nateGeorge/ESP-8266-particle-sensor/NodeMcu/proto board before soldering.jpg

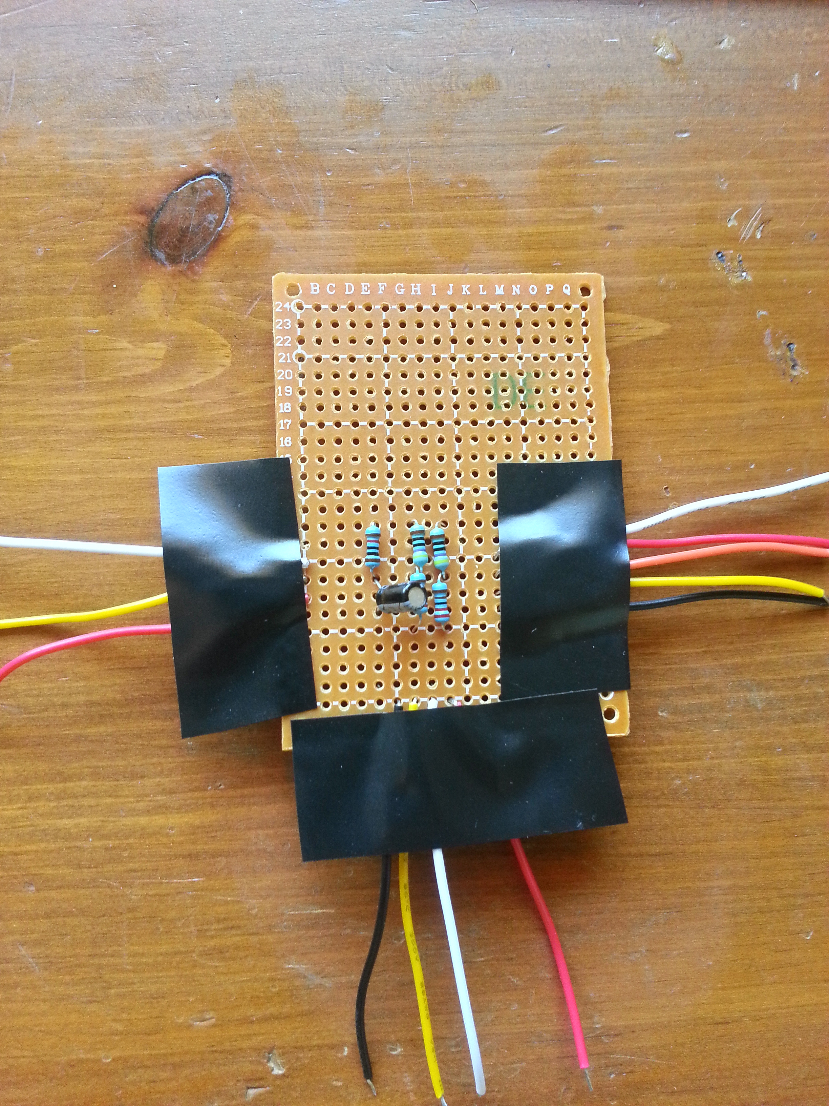
NodeMcu/proto board before soldering.jpg
