nateGeorge/ESP-8266-particle-sensor/NodeMcu/proto board with connections.jpg

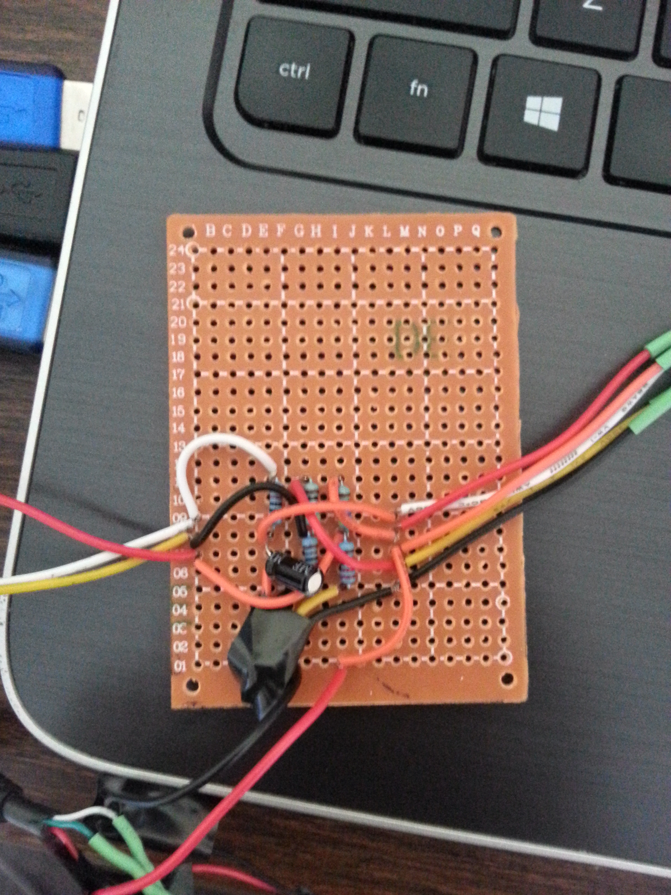
NodeMcu/proto board with connections.jpg
