nateGeorge/ESP-8266-particle-sensor/NodeMcu/enclosure/box-20151013_195903_868115.pdf

Cut Width: 0.0000mm
Material Thickness: 2.7000mm
W x D x H: 101.60mm x 88.90mm x 63.50mm Produced by BoxMaker v2.0.1 on 10/13/2015 at 19:59:03 http://boxmaker.connectionlab.org
