nateGeorge/ESP-8266-particle-sensor/arduino+esp01/correlation data/8-6-15 correlations.png

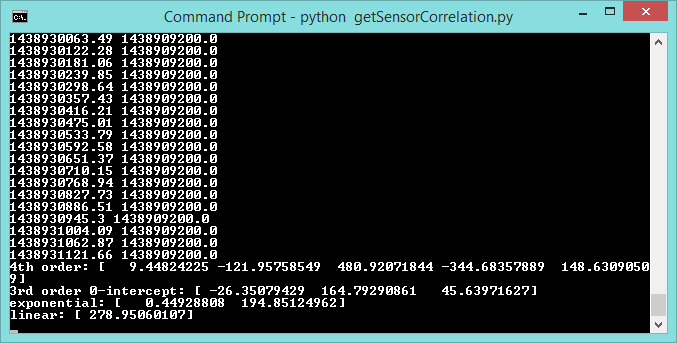
arduino+esp01/correlation data/8-6-15 correlations.png
