nateGeorge/ESP-8266-particle-sensor/arduino+esp01/correlation data/data from linear fit.png

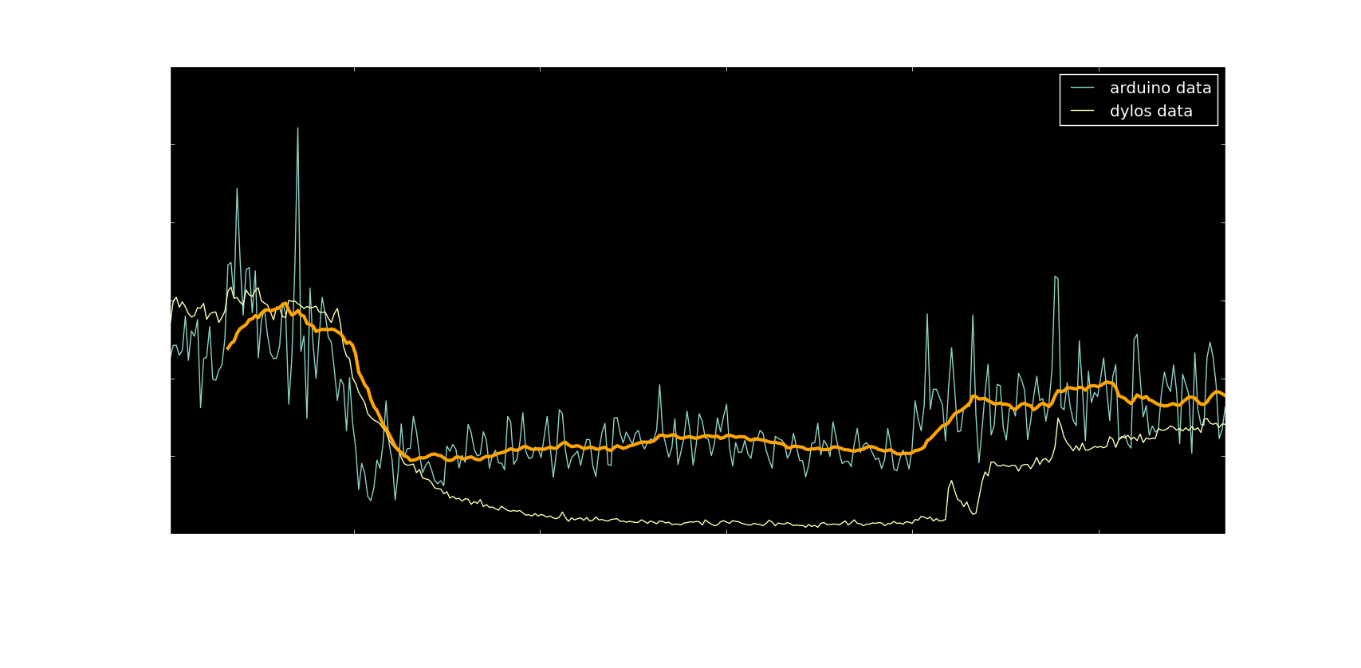
arduino+esp01/correlation data/data from linear fit.png
