nateGeorge/ESP-8266-particle-sensor/arduino+esp01/correlation data/low P1 ratio.png

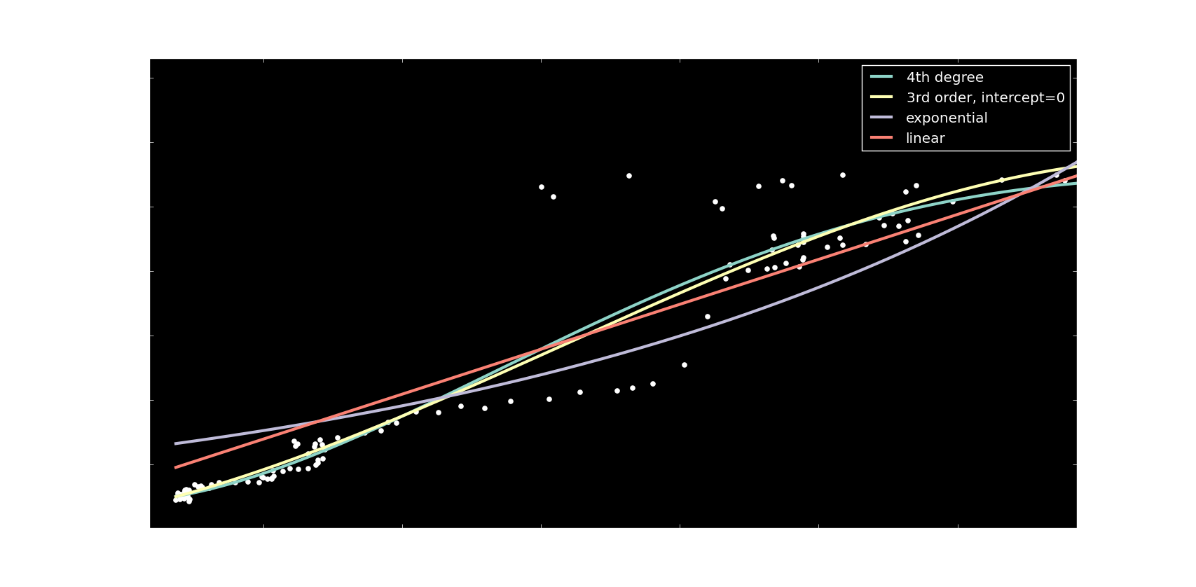
arduino+esp01/correlation data/low P1 ratio.png
