nateGeorge/ESP-8266-particle-sensor/arduino+esp01/correlation data/P1 ratio dylos fit.png

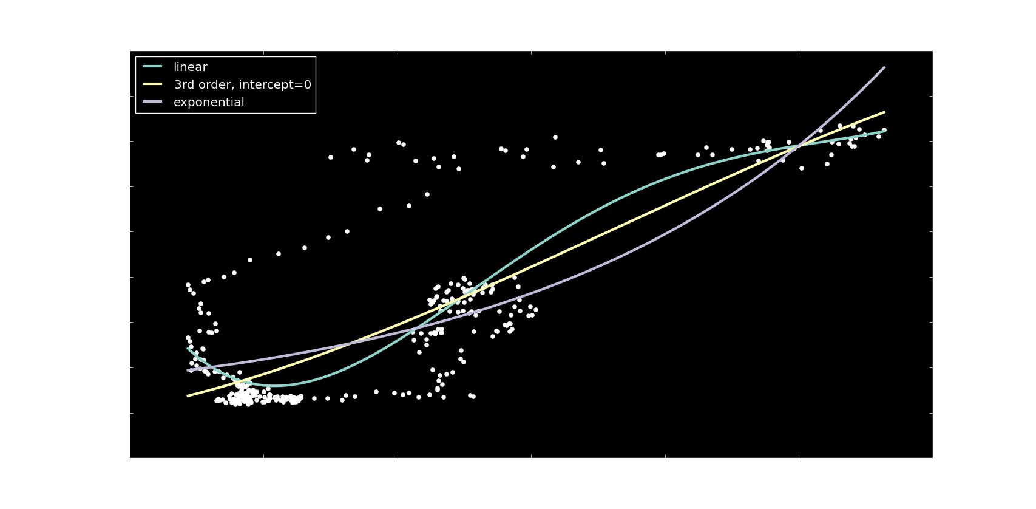
arduino+esp01/correlation data/P1 ratio dylos fit.png
