nateGeorge/ESP-8266-particle-sensor/arduino+esp01/correlation data/raw p1 data.png

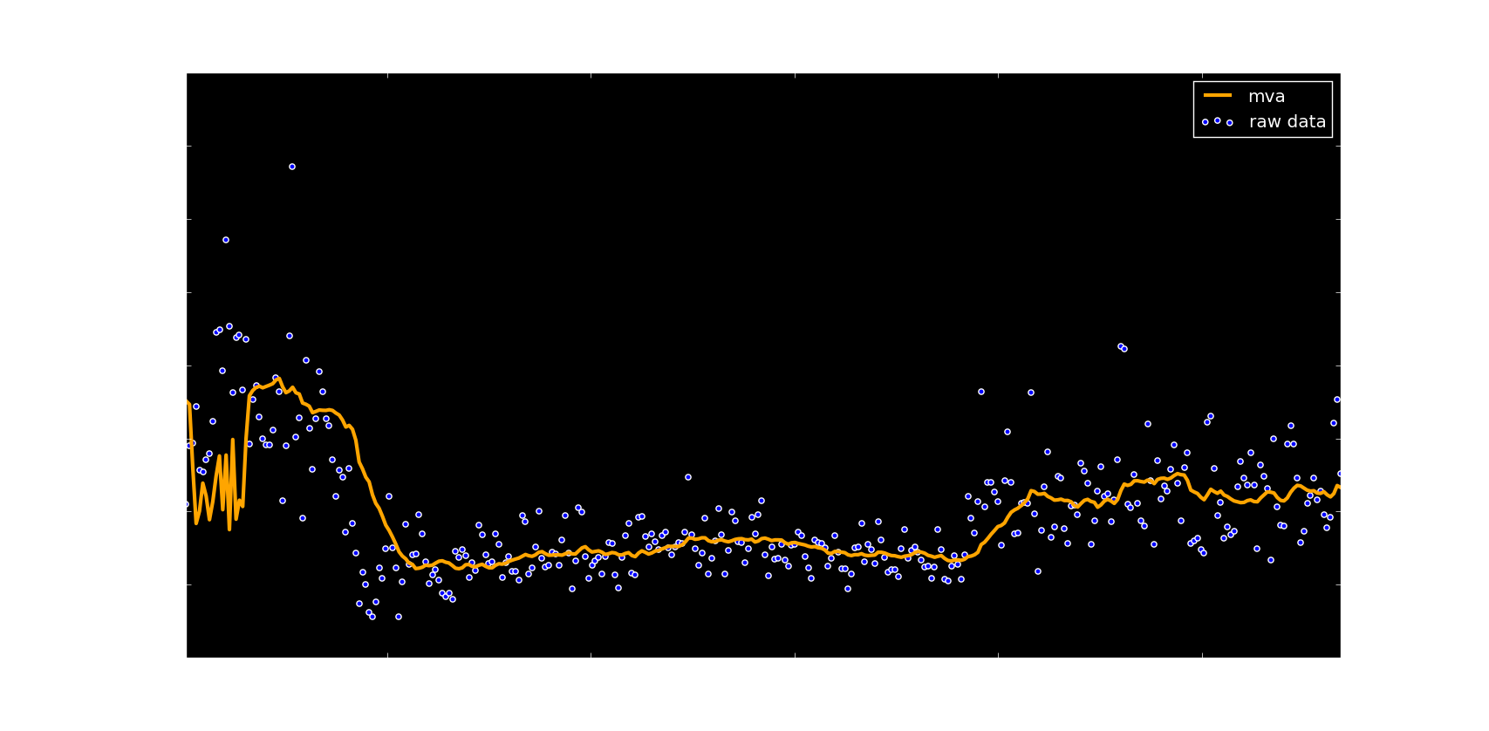
arduino+esp01/correlation data/raw p1 data.png
