nateGeorge/ESP-8266-particle-sensor/background info/dylos plot.png

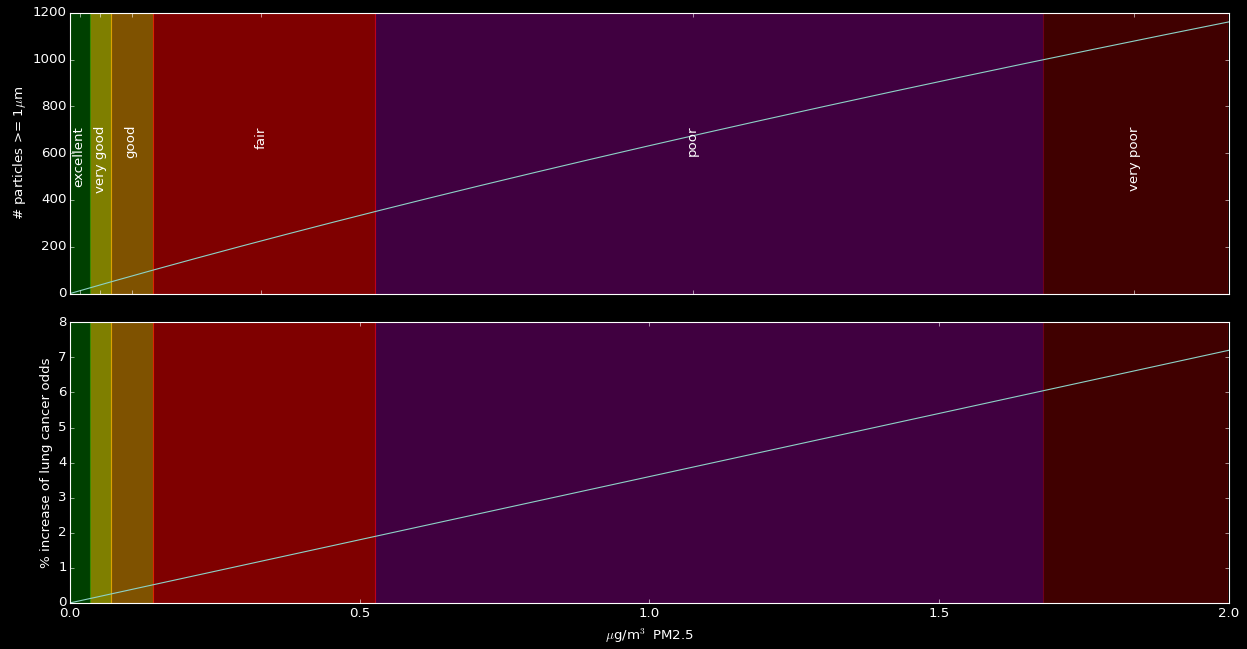
background info/dylos plot.png
