nateGeorge/ESP-8266-particle-sensor/background info/overall plot.png

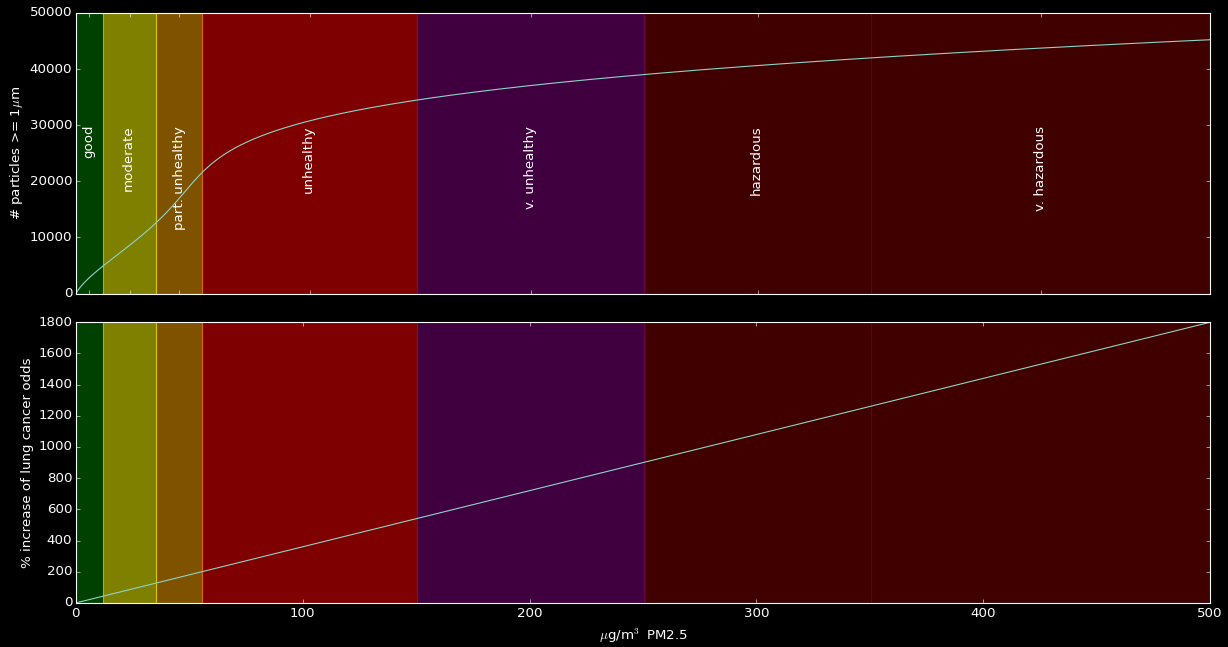
background info/overall plot.png
