nateGeorge/ESP-8266-particle-sensor/NodeMcu/5V downconversion.bmp

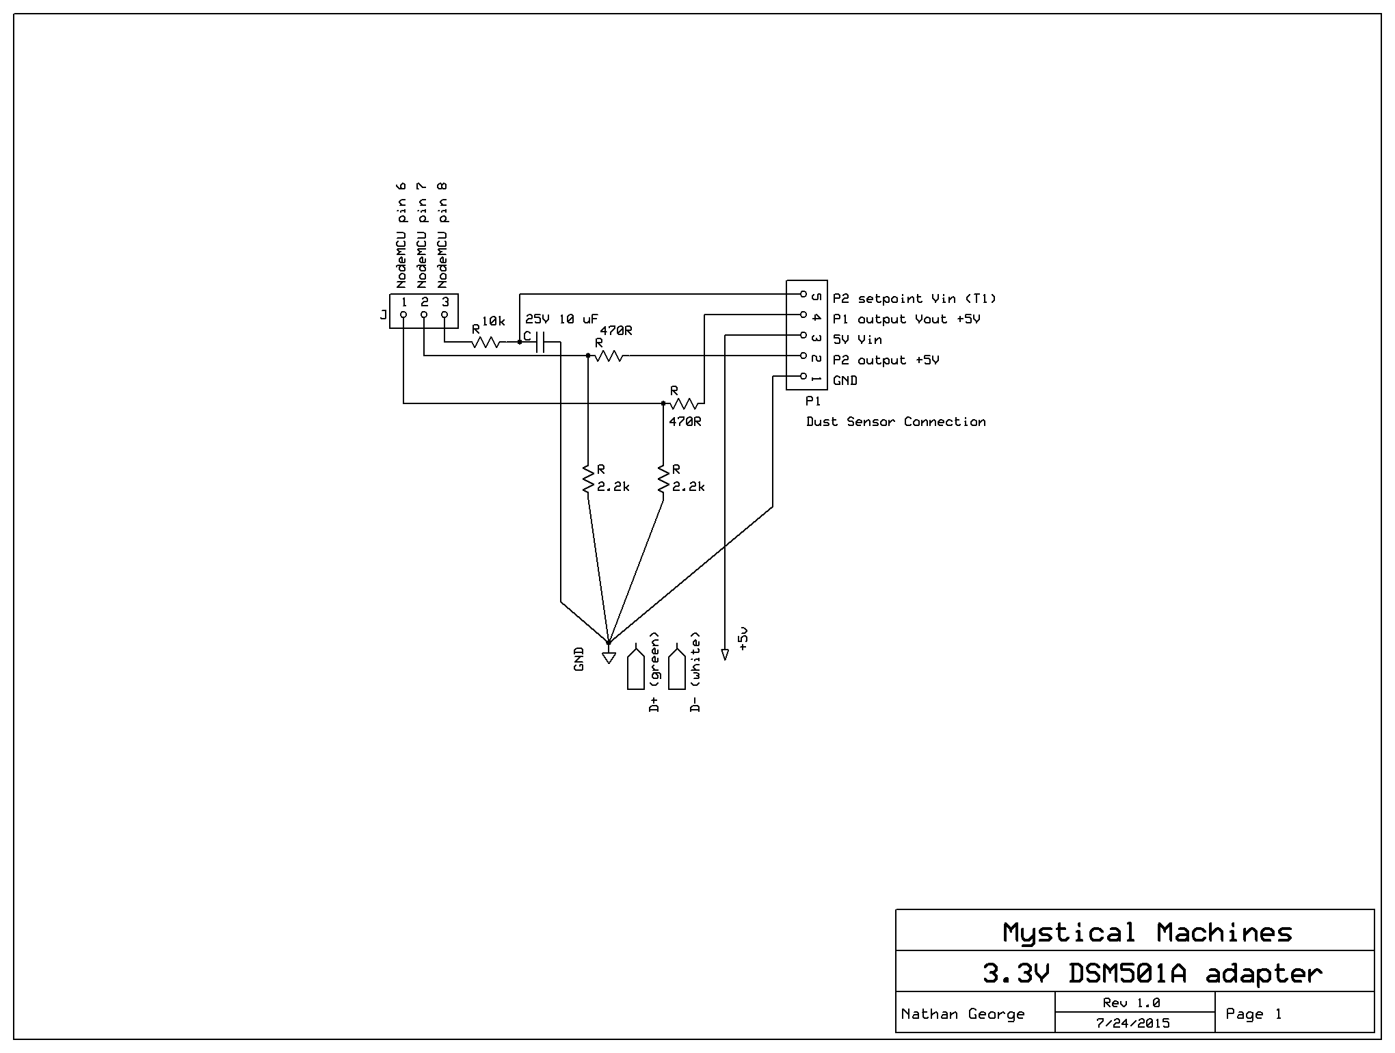
NodeMcu/5V downconversion.bmp
