nateGeorge/ESP-8266-particle-sensor/spec sheets/DSM501A ratio to mg-m3.png

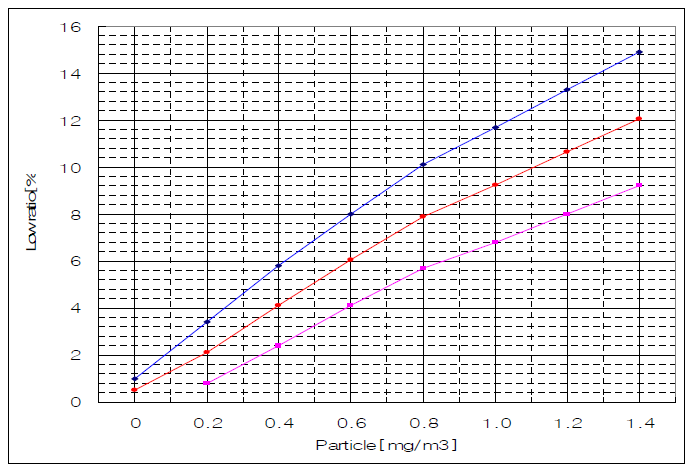
spec sheets/DSM501A ratio to mg-m3.png
