nateGeorge/ESP-8266-particle-sensor/spec sheets/DSM501A ratio to particle-001 ft3.png

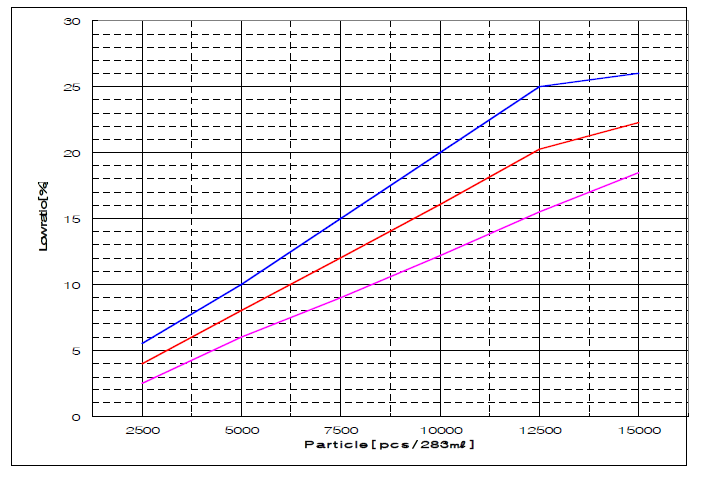
spec sheets/DSM501A ratio to particle-001 ft3.png
