nateGeorge/ESP-8266-particle-sensor/business documents/costs.xlsx

item | cost
nodeMCU devkit | 5
custom circuit | 1
lcd screen | 2
ppd42ns | 10
case | 10
other (cables, etc) | 1
total | 29
 | 75.4
