nateGeorge/ESP-8266-particle-sensor/NodeMcu/cost and power calculations.xlsx

Sheet: costs
 | total cost | cost per item | # items | item | link
 | 12 | 12 | 1 | PPD42NS | http://www.aliexpress.com/item/Free-shipping-PM2-5-dust-sensor-PPD42NJ-PPD42NS-with-cable/32408582269.html
 | 2.24 | 2.24 | 1 | ESP8266 ESP-12 | http://www.aliexpress.com/item/Free-Shipping-ESP8266-serial-WIFI-model-ESP-12-ESP-12E-ESP12E-Authenticity-Guaranteed-ESP12/32353579773.html
 | 0.34 | 0.34 | 1 | battery charger | http://www.alibaba.com/product-detail/TP4056-1A-Lipo-Battery-Charging-Board_60305109787.html
 | 0 | 2.45 |  | 4500 mAh batteries | http://www.alibaba.com/product-detail/9-6Wh-high-capacity-4500mah-Li_60279237019.html
 | 3.14 | 1.57 | 2 | 8800 mAh batteries | http://www.aliexpress.com/item/Free-Shipping-10-Pcs-18650-battery-Ultrafire-bateria-3-7V-8800mAh-Li-ion-Rechargeable-Battery-Flashlight/32297733829.html
 | 0.8 | 0.8 | 1 | battery holder | http://www.aliexpress.com/item/2Pcs-lot-18650-Battery-Holder-Battery-Storage-Box-With-Pin-TBH-186502AP-Free-Shipping/32336098533.html
 | 0.085 | 0.085 | 1 | 5v regulator | http://www.aliexpress.com/item/10pcs-L7805CV-L7805-7805-Voltage-Regulator-5V-1-5A-TO-220/32266509032.html
 | 0.04 | 0.04 | 1 | 3.3v regulator | http://www.aliexpress.com/item/10pcs-AMS1117-3-3-AMS1117-LM1117-1117-3-3V-1A-Voltage-Regulator/32409097011.html
 | 0.08 | 0.08 | 1 | micro usb connector | http://www.aliexpress.com/item/Short-term-Sacrifices-5pcs-USB-Micro-Type-B-5pin-Female-Jack-Connector-SMT-Surface-Mount/32349977492.html
 | 0.72 | 0.72 | 1 | micro usb cable | http://www.aliexpress.com/item/1-Meter-3-Feet-Ruggedized-Fabric-Braided-USB-Male-to-Micro-USB-Male-Data-Sync-Charging/32340270515.html
 | 3.6 | 3.6 | 1 | tft screen | http://www.aliexpress.com/item/Free-shipping-New-1-44-inch-LCD-color-screen-for-arduino-1-44-TFT-SPI-serial/32233128819.html
 | 0.75 | 0.75 | 1 | rgb led | http://www.aliexpress.com/item/1Pcs-3-Colour-RGB-SMD-LED-Board-Module-5050-Full-Color-LED-3-3-5V-for/2055617889.html
 | 5 | 5 | 1 | circuit board
 | 5 | 5 | 1 | case
subtotal | 33.795
 |  | 0.001798 |  | smd resistors 10k | http://www.aliexpress.com/item/0603-10K-Ohm-5-1-10W-RoHS-Chip-Fixed-Resistor-SMD-Resistor-5000pcs-full-reel/32260947174.html
 | WIRELESS OPTION
 | 2.4 | 2.4 | 1 | wireless charging reciever | http://www.aliexpress.com/item/Ultra-Thin-S4-i9500-Qi-Wireless-Charger-Charging-Receiver-Adapter-Coil-for-Samsung-Galaxy-S4-i9500/32344269583.html
 | 4.13 | 4.13 | 1 | wireless charging pad | http://www.aliexpress.com/item/5-Colors-Universal-Qi-Wireless-Power-Charging-Charger-Pad-For-Mobile-Phone-for-iPhone-6-High/32357207384.html
subtotal | 6.53

Sheet: power usage
piece | time fraction | A | V | power (W) | power (Wh) required run for 3 hours
ESP8266 wifi | 0.1666666667 | 0.4 | 3.7 | 1.48 | 6.36 | Wh
dust sensor | 1 | 0.1 | 6.4 | 0.64 | 1718.918919 | mAh
 |  |  |  |  | hours with 9.6Wh (4800 mAh)
 |  |  |  |  | 4.528301887
sum |  |  |  | 2.12
