nateGeorge/ESP-8266-particle-sensor/background info/DSM501A ratio to mg-m3.xlsx

Sheet: pcs per 0.01ft3
LPO | particles / 0.01ft3 | LPO | upper error | LPO | lower error
3.993520653 | 2526.053319 | 5.496683866 | 2506.01775 | 2.424884318 | 2524.354189
7.993384723 | 5000.056638 | 9.954180142 | 5002.180549 | 5.901869609 | 4997.791132
14.0916737 | 8797.823415 | 17.621332 | 8844.974258 | 9.117981887 | 7579.26439
20.25486942 | 12509.00539 | 25.02613828 | 12514.17357 | 12.39945401 | 10160.80845
22.29405135 | 15002.54869 | 26.01967592 | 15028.24803 | 18.50306693 | 14976.77856

Sheet: DSM501A ratio to mg-m3
low pulse ratio | mg/m3 | LPO | upper error limit | LPO | lower error limit
0.5474452555 | -0.0001300345025 | 1.02189781 | -0.0002427310713 | 0.802919708 | 0.2017095203
2.116788321 | 0.1966468436 | 3.430656934 | 0.2010853546 | 2.445255474 | 0.3984690605
4.160583942 | 0.398061619 | 5.839416058 | 0.3976628465 | 4.124087591 | 0.5952199317
6.094890511 | 0.5971271044 | 8.02919708 | 0.5966676491 | 5.693430657 | 0.7967474036
7.919708029 | 0.7962185967 | 10.1459854 | 0.7956897897 | 6.824817518 | 0.9960036063
9.233576642 | 0.9954314545 | 11.67883212 | 0.9972259306 | 8.02919708 | 1.195242471
10.65693431 | 1.194618305 | 13.32116788 | 1.193985471 | 9.233576642 | 1.396856633
12.04379562 | 1.393813825 | 14.89051095 | 1.395512943

Sheet: Resistors for v1 output
R | size (um)
inf | 2.5
100k | 1.75
27k | 1

Sheet: convert part-ft3 to ug-m3
y = 4E-16x4 – 2E-11x3 + 3E-07x2 + 0.0014x + 1.9915
from aircasting thesis https://dl.dropboxusercontent.com/u/29720355/Besser%20Thesis%20FINAL.pdf
using shinyei ppd60v t2
Subsequent particle studies have shown distributions for airborne particles proportional to 1/(diameter)^2.1.
(number of particles > 1 µm)* [1/(ratio of particle diameters)^2.1 ]
http://www.pmeasuring.com/wrap/filesApp/BasicGuide/file_1/ver_1317144880/basicguide.pdf
conversion factor
4.28709385
particle size 1 | size 2
0.5 | 1

Sheet: limits for exposure
aircasting 2.5um | hunderds of particles per cubic foot, lower | upper | lower ug/m3 | upper |  | y = 4E-16x4 – 2E-11x3 + 3E-07x2 + 0.0014x + 1.9915
very poor | 7500 |  | 22.194625
poor | 5000 | 7500 | 14.2415 | 22.194625
fair | 2500 | 5000 | 7.069625 | 14.2415
good | 2500 |  | 7.069625
 |  |  |  |  | converts hundreds of particles per ft3 to ug/m3, which is the same as particles per 0.01 ft3 output by shinyei
1 um counts per 0.01 ft3 converted to EPA scale | 41976.60367 |  | 350.0000072 |  | 4E-16x4 – 2E-11x3 + 3E-07x2 + 0.0014x + 1.9915
 | 39003.64076 |  | 250.0000024
from aircasting thesis https://dl.dropboxusercontent.com/u/29720355/Besser%20Thesis%20FINAL.pdf | 34452.2175 |  | 149.9999998
 | 21304.58182 |  | 54.99999839
 | 12470.54384 |  | 35.00000111
 | 4919.226481 |  | 11.9999999
dylos 1um |  |  |  |  | converted to 0.5 um with 4.29
very poor | 1000 |  | 1.68 |  | 4290
poor | 350 | 1000 | 0.53 | 1.68 | 1501.5
fair | 100 | 350 | 0.14 | 0.53 | 429
good | 50 | 100 | 0.07 | 0.14 | 214.5
very good | 25 | 50 | 0.04 | 0.07 | 107.25
excellent | 0 | 25 | 0.00 | 0.04 | 0
dylos 0.5um |  |  |  |  | converted to 1 um with 4.29 factor
very poor | 3000 |  | 30 |  | 699.3006993
poor | 1050 | 3000 | 10.5 | 30 | 244.7552448
fair | 300 | 1050 | 3 | 10.5 | 69.93006993
good | 150 | 300 | 1.5 | 3 | 34.96503497
very good | 75 | 150 | 0.75 | 1.5 | 17.48251748
excellent | 0 | 75 | 0 | 0.75 | 0
US EPA NAAQS | http://www.epa.gov/air/criteria.html | http://www.epa.gov/airquality/particlepollution/2012/decfsstandards.pdf
24 hour period |  |  | 35
1 year |  |  | 12
very hazardous |  |  | 350
hazardous |  |  | 250 | 350
very unhealthy |  |  | 150 | 250
unhealthy |  |  | 55 | 150
unhealthy for sensitive groups |  |  | 35 | 55
moderate |  |  | 12 | 35
good |  |  | 0 | 12
WHO 2.5um standards | http://www.who.int/mediacentre/factsheets/fs313/en/
24 hour |  |  | 25
1 year |  |  | 10

Sheet: Low P1 ratio to counts
P1 ratio | particles in 0.01 cu ft
0.6998420221 | 98.30508475
2.678515008 | 789.8305085
3.302527646 | 966.1016949
3.859399684 | 1101.694915
1.197472354 | 261.0169492
1.596366509 | 383.0508475
