nateGeorge/ESP-8266-particle-sensor/(commit log)

2015-07-26 added pics of proto board
2015-07-28 had tx, rx reversed on esp
    [particle_monitor_with_P2_output_sparkfun_logging.ino]
2015-08-01 lowered timeout and fixed re
    [save arduino data.py]
2015-08-01 had p2/p1 concs switched
2015-08-01 added NAAQS and WHO standards, conversion to ug/m3
    [DSM501A ratio to mg-m3.xlsx]
2015-08-02 added more data on thresholds
    [DSM501A ratio to mg-m3.xlsx]
2015-08-02 fixed date in filename
    [save arduino data.py, save dylos data.py]
2015-08-02 changed fan pin #
    [2015-08-02 09-17-57 dylos data.csv, 2015-08-02 09-18-19 arduino data.csv]
2015-08-02 added data
    [2015-08-02 09-17-57 dylos data.csv, 2015-08-02 09-18-19 arduino data.csv]
2015-08-02 Revert "initial commit"
    This reverts commit 0eaaa4d6554e546bd2d77d9edb31613e7b3fff55.
    [getSensorCorrelation with lots of filtering.py, getSensorCorrelation.py]
2015-08-02 Revert "Revert "initial commit""
    This reverts commit f83eabcf0bed7aa63dcd10e2291b99bf970a7a38.
    [getSensorCorrelation with lots of filtering.py]
2015-08-07 initial commi
    [2015-08-06 21-14-21 arduino data.csv, 2015-08-06 21-15-04 dylos data.csv]
2015-08-10 updated correlation
    [DSM501A ratio to mg-m3.xlsx]
2015-08-10 updated correlations
    [DSM501A ratio to mg-m3.xlsx]
2015-08-14 added resistors
    [cost and power calculations.xlsx]
2015-08-14 added rest of parts
    [cost and power calculations.xlsx]
2015-08-18 rearranged organization and concat and save data
    [2015-08-02 09-17-57 dylos data.csv, 2015-08-02 09-18-19 arduino data.csv, 2015-08-06 21-14-21 arduino data.csv, 2015-08-06 21-15-04 dylos data.csv, 2015-08-08 12-17-45 arduino data.csv, 2015-08-08 12-17-46 dylos data.csv, 2015-08-15 16-23-31 arduino data.csv, 2015-08-15 16-23-58 dylos data.csv]
2015-08-18 added one line
    [DSM501A ratio to mg-m3.xlsx]
2015-08-19 fixed time issues, looking at latest data
    [getSensorCorrelation.py]
2015-08-21 more data
    [2015-08-19 08-27-09 arduino data.csv, 2015-08-19 08-27-15 dylos data.csv, 2015-08-20 14-35-28 arduino data.csv, 2015-08-20 14-35-33 dylos data.csv]
2015-08-23 add data
    [2015-08-21 09-09-27 arduino data.csv, 2015-08-21 09-09-36 dylos data.csv, 2015-08-22 09-07-52 arduino data.csv, 2015-08-22 09-07-55 dylos data.csv, 2015-08-22 16-28-47 arduino data.csv, 2015-08-22 16-28-50 dylos data.csv]
2015-10-03 added health regime analysis
    [2015-08-23 10-11-05 arduino data.csv, 2015-08-23 10-11-07 dylos data.csv, 2015-08-23 14-48-16 dylos data.csv, 2015-08-23 14-48-18 arduino data.csv, DSM501A ratio to mg-m3.xlsx, concatd data - 2015-08-17.csv, health regimes.xlsx, spark particle board.sch]
2015-10-11 remove p2 pin
2015-11-04 added acrylic case
